PAWANPAHUNE/-Computer-Vision-Based-Laser-Line-Triangulation-Sensor-for-Weld-Bead-Geometry-Measurement/software/assets/checkerboard_9x6_10mm.pdf

Inner corners: 9 x 6 Squares: 10 x 7 Square size: 10 mm
PRINT AT 100% / ACTUAL SIZE. Turn OFF ’Fit to page’. Check: the bar below must measure exactly 100 mm.

100 mm
