PAWANPAHUNE/-Computer-Vision-Based-Laser-Line-Triangulation-Sensor-for-Weld-Bead-Geometry-Measurement/software/assets/checkerboard_9x6_25mm.pdf

Inner corners 9 x 6 | squares 10 x 7 | square 25 mm | PRINT AT 100% (no Fit to page) | CHECK: 4 squares = 100 mm
