PAWANPAHUNE/-Computer-Vision-Based-Laser-Line-Triangulation-Sensor-for-Weld-Bead-Geometry-Measurement/cad/fixture_final/4_pictures/fixture_with_camera_laser_torch_rear.png

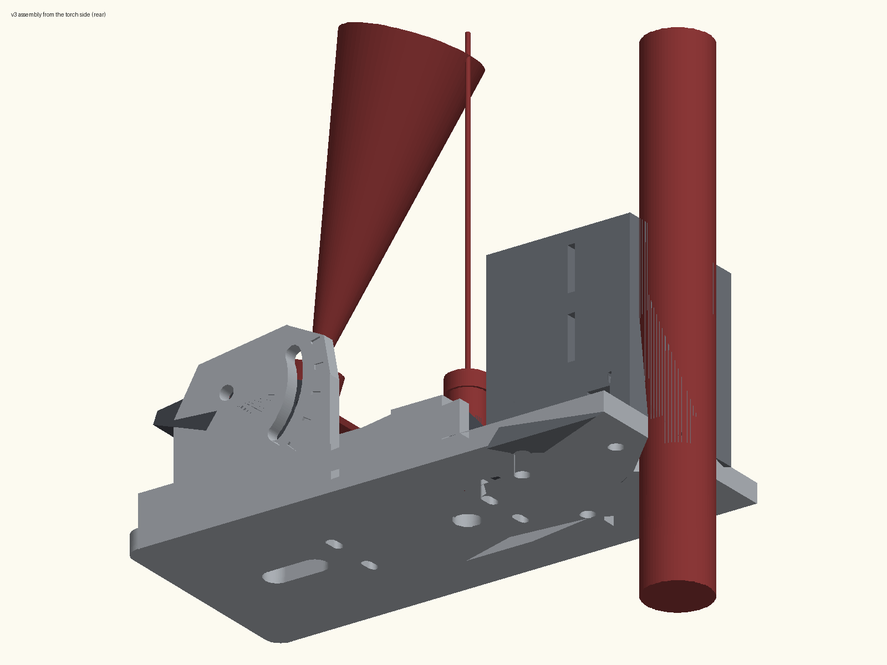
cad/fixture_final/4_pictures/fixture_with_camera_laser_torch_rear.png
