PAWANPAHUNE/-Computer-Vision-Based-Laser-Line-Triangulation-Sensor-for-Weld-Bead-Geometry-Measurement/software/photos/1_checkerboard/view_01.png

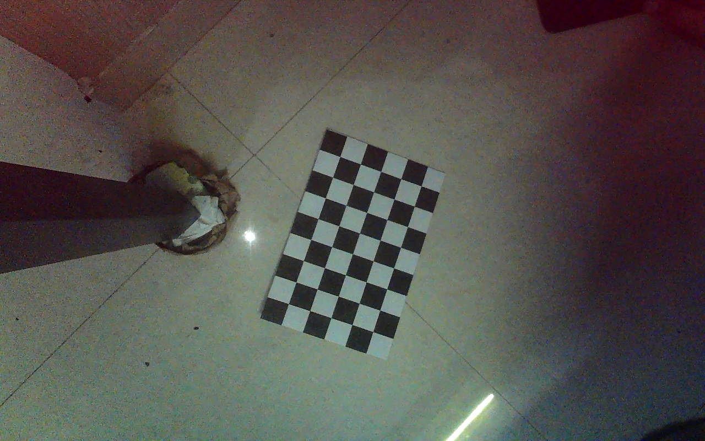
software/photos/1_checkerboard/view_01.png
