PAWANPAHUNE/-Computer-Vision-Based-Laser-Line-Triangulation-Sensor-for-Weld-Bead-Geometry-Measurement/software/photos/2_laser_plane/pose_06_laser_off.png

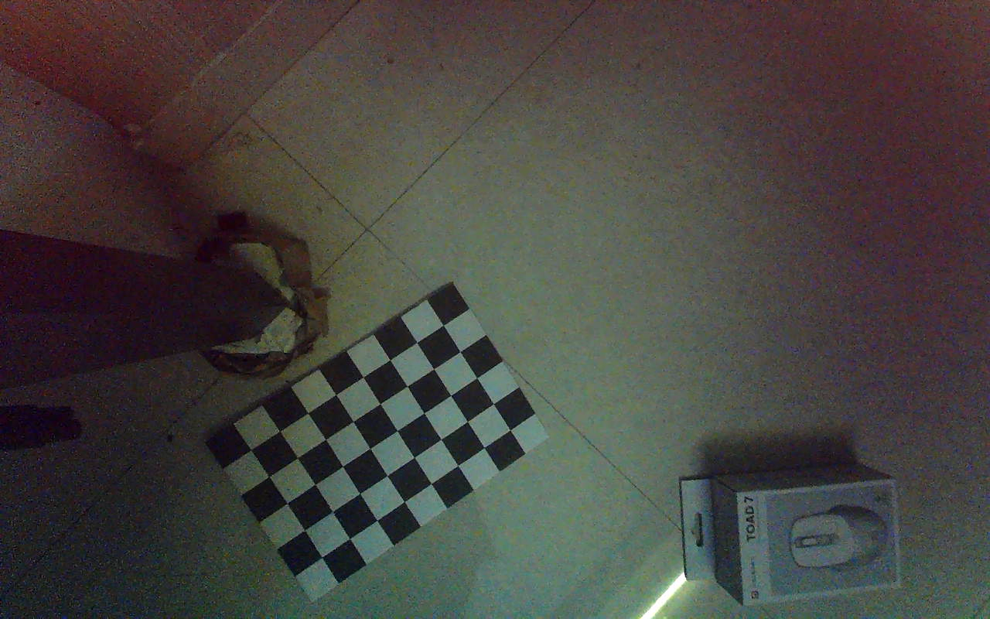
software/photos/2_laser_plane/pose_06_laser_off.png
