PAWANPAHUNE/-Computer-Vision-Based-Laser-Line-Triangulation-Sensor-for-Weld-Bead-Geometry-Measurement/software/photos/4_weld/weld_03.png

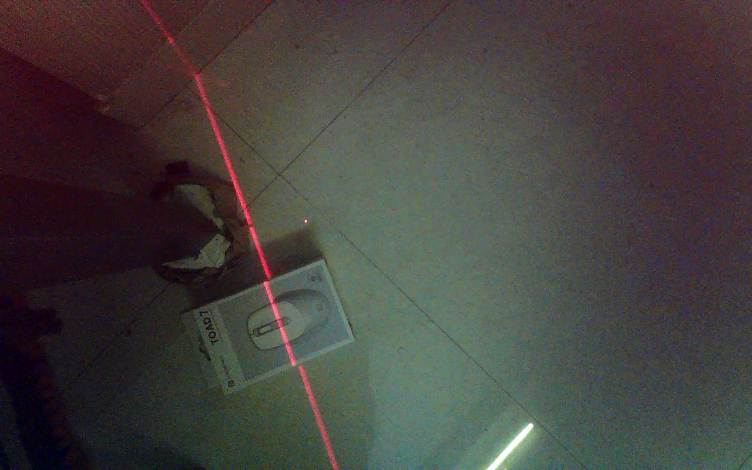
software/photos/4_weld/weld_03.png
