PAWANPAHUNE/-Computer-Vision-Based-Laser-Line-Triangulation-Sensor-for-Weld-Bead-Geometry-Measurement/docs/images/shopping_list.jpg

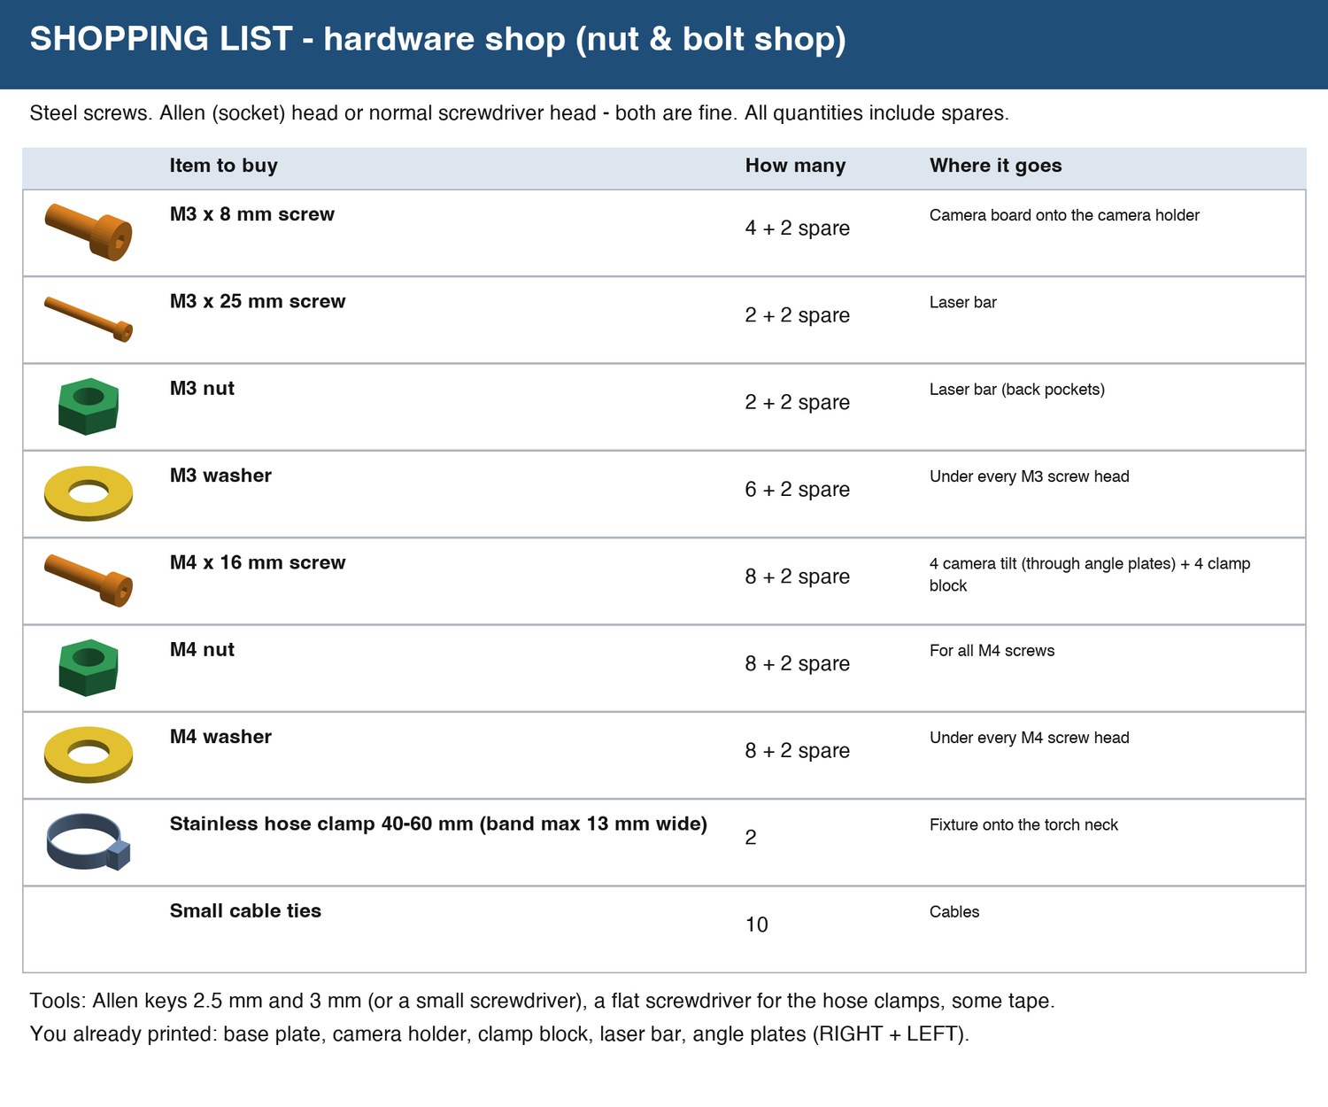
docs/images/shopping_list.jpg
