PAWANPAHUNE/-Computer-Vision-Based-Laser-Line-Triangulation-Sensor-for-Weld-Bead-Geometry-Measurement/cad/design_history/v3/camera_yoke.stl

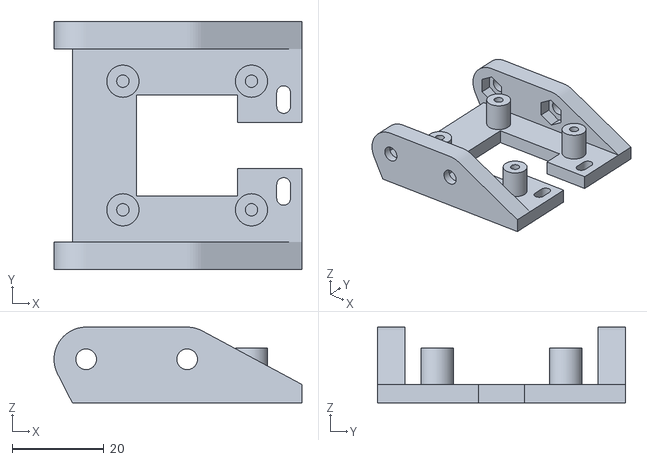
[picture p77: CAD file, 2026-11-10]
cad/design_history/v3/camera_yoke.stl
54.0 x 54.0 x 16.5
