PAWANPAHUNE/-Computer-Vision-Based-Laser-Line-Triangulation-Sensor-for-Weld-Bead-Geometry-Measurement/cad/design_history/v3/printed_hardware/stl/strap_long.stl

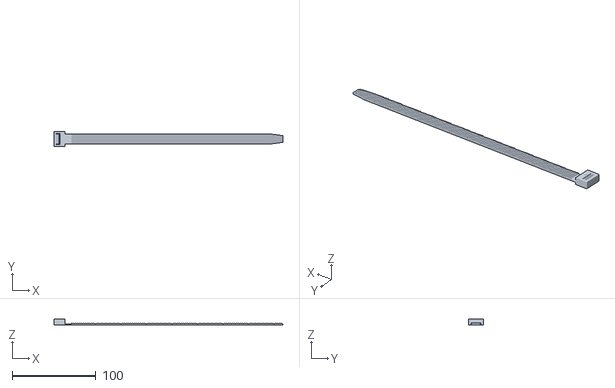
[picture p79: CAD file, 2026-11-10]
cad/design_history/v3/printed_hardware/stl/strap_long.stl
273.0 x 18.0 x 7.00
