PAWANPAHUNE/-Computer-Vision-Based-Laser-Line-Triangulation-Sensor-for-Weld-Bead-Geometry-Measurement/cad/fixture_final/1_fixture_parts_ALREADY_PRINTED/arm_clamp.stl

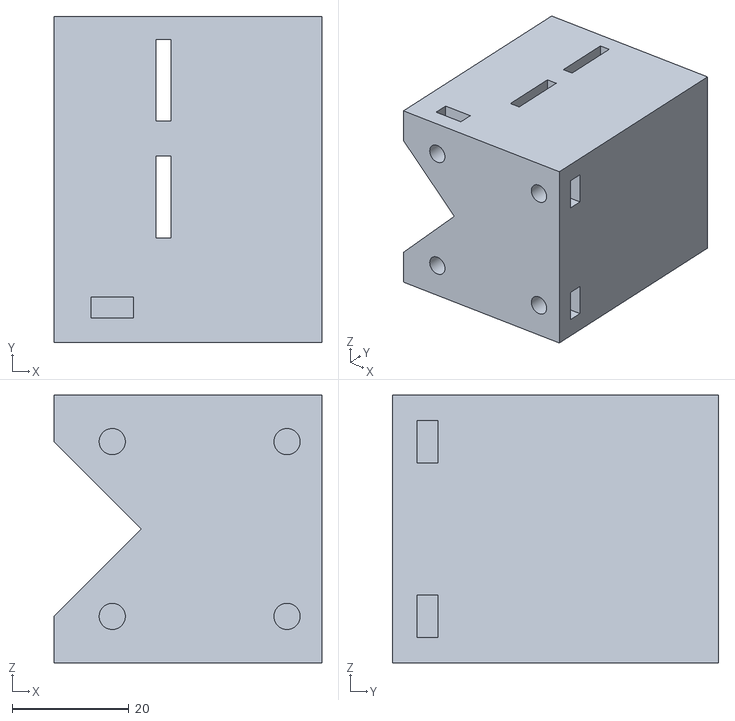
[picture p80: CAD file, 2026-11-10]
cad/fixture_final/1_fixture_parts_ALREADY_PRINTED/arm_clamp.stl
46.0 x 56.0 x 46.0
