PAWANPAHUNE/-Computer-Vision-Based-Laser-Line-Triangulation-Sensor-for-Weld-Bead-Geometry-Measurement/cad/design_history/v3/printed_hardware/stl/angle_plates/angle_plate_25deg_RIGHT.stl

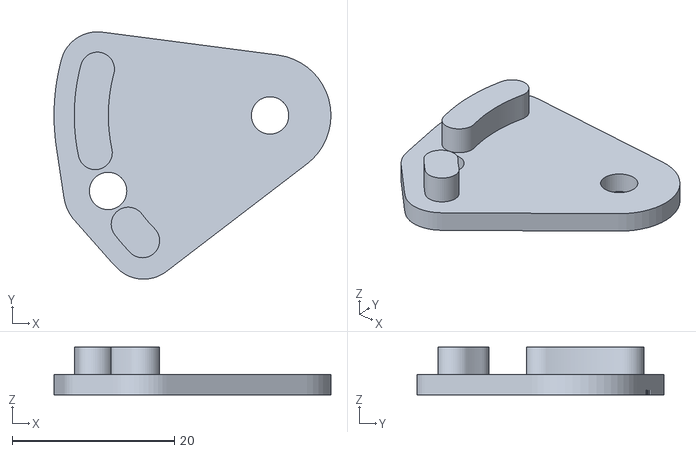
[picture p81: CAD file, 2026-11-10]
cad/design_history/v3/printed_hardware/stl/angle_plates/angle_plate_25deg_RIGHT.stl
34.1 x 30.5 x 5.90
