PAWANPAHUNE/-Computer-Vision-Based-Laser-Line-Triangulation-Sensor-for-Weld-Bead-Geometry-Measurement/cad/fixture_final/1_fixture_parts_ALREADY_PRINTED/base.stl

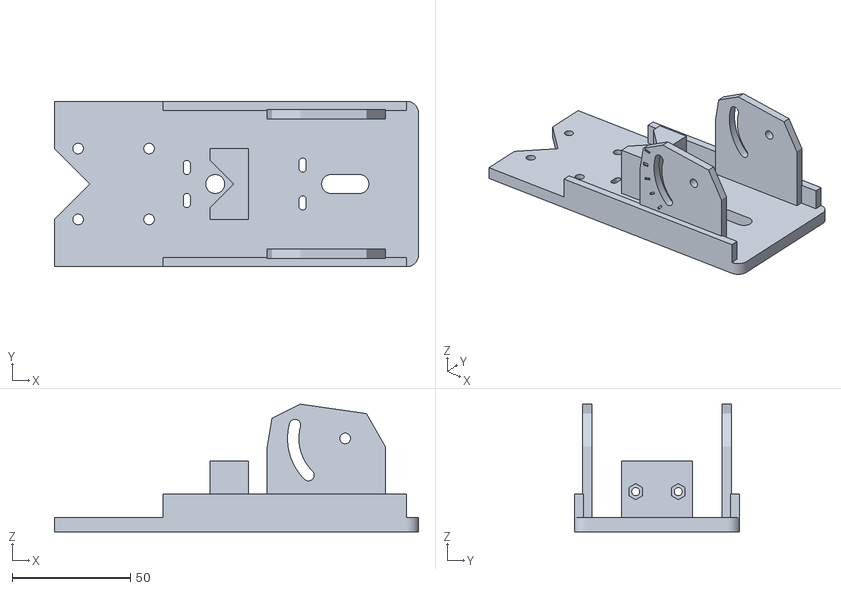
[picture p83: CAD file, 2026-11-10]
cad/fixture_final/1_fixture_parts_ALREADY_PRINTED/base.stl
154.0 x 70.0 x 54.0
