PAWANPAHUNE/-Computer-Vision-Based-Laser-Line-Triangulation-Sensor-for-Weld-Bead-Geometry-Measurement/cad/design_history/v3/laser_bar.stl

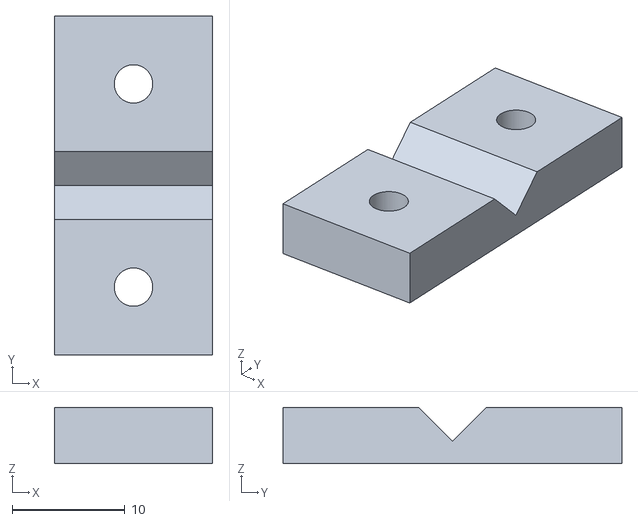
[picture p85: CAD file, 2026-11-10]
cad/design_history/v3/laser_bar.stl
14.0 x 30.0 x 5.00
