PAWANPAHUNE/-Computer-Vision-Based-Laser-Line-Triangulation-Sensor-for-Weld-Bead-Geometry-Measurement/cad/design_history/v3/printed_hardware/stl/laser_clip_size1.stl

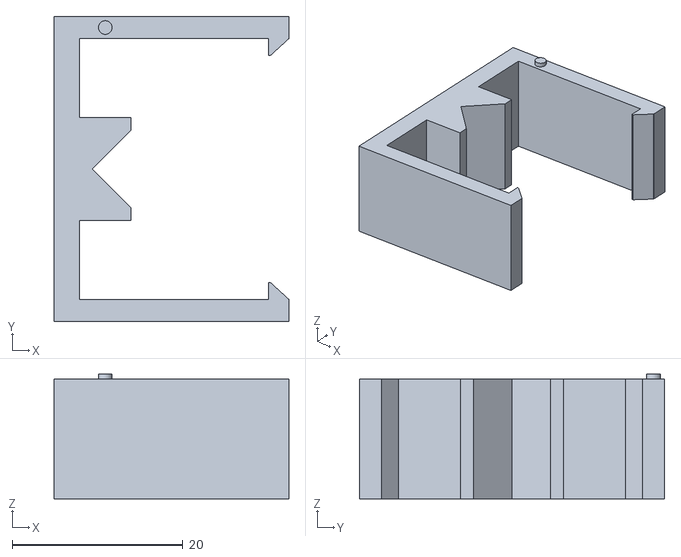
[picture p86: CAD file, 2026-11-10]
cad/design_history/v3/printed_hardware/stl/laser_clip_size1.stl
27.5 x 35.7 x 14.6
