PAWANPAHUNE/-Computer-Vision-Based-Laser-Line-Triangulation-Sensor-for-Weld-Bead-Geometry-Measurement/cad/fixture_final/2_print_pins_clips_straps/yoke_pin.stl

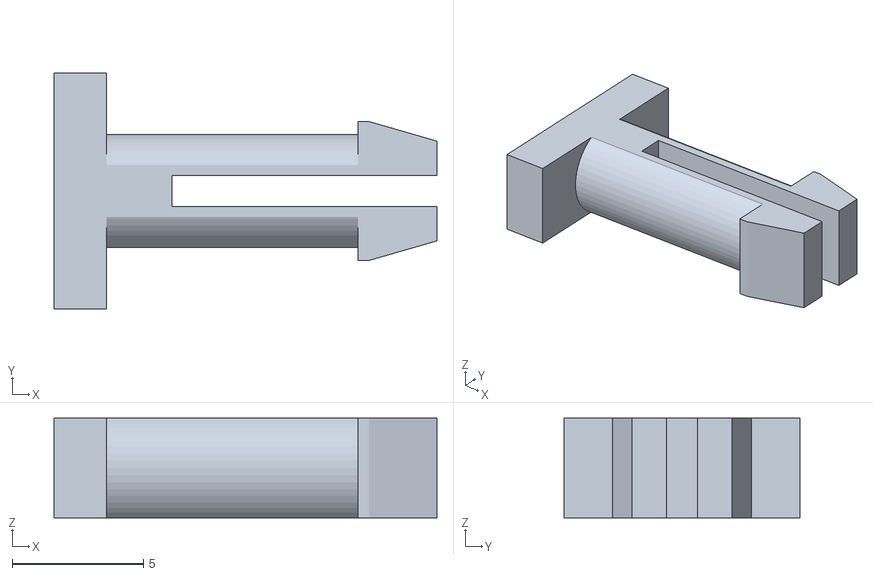
[picture p87: CAD file, 2026-11-10]
cad/fixture_final/2_print_pins_clips_straps/yoke_pin.stl
14.6 x 9.00 x 3.80
