PAWANPAHUNE/-Computer-Vision-Based-Laser-Line-Triangulation-Sensor-for-Weld-Bead-Geometry-Measurement/cad/design_history/v3/printed_hardware/stl/strap_short.stl

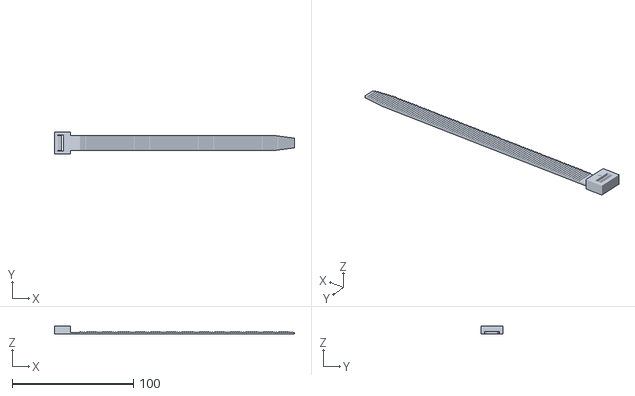
[picture p89: CAD file, 2026-11-10]
cad/design_history/v3/printed_hardware/stl/strap_short.stl
198.0 x 18.0 x 7.00
