PAWANPAHUNE/-Computer-Vision-Based-Laser-Line-Triangulation-Sensor-for-Weld-Bead-Geometry-Measurement/cad/fixture_final/2_print_pins_clips_straps/block_fork_side.stl

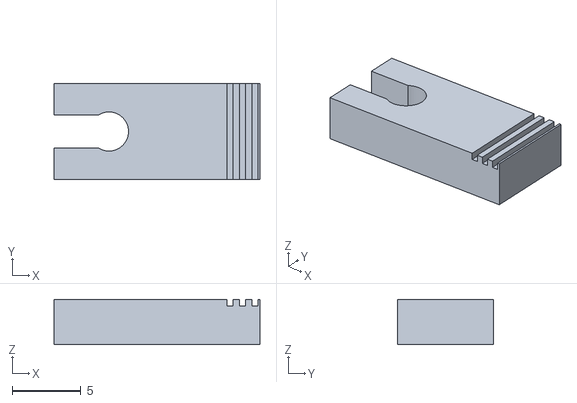
[picture p90: CAD file, 2026-11-10]
cad/fixture_final/2_print_pins_clips_straps/block_fork_side.stl
15.0 x 7.00 x 3.30
