PAWANPAHUNE/-Computer-Vision-Based-Laser-Line-Triangulation-Sensor-for-Weld-Bead-Geometry-Measurement/cad/design_history/v3/printed_hardware/stl/camera_pin.stl

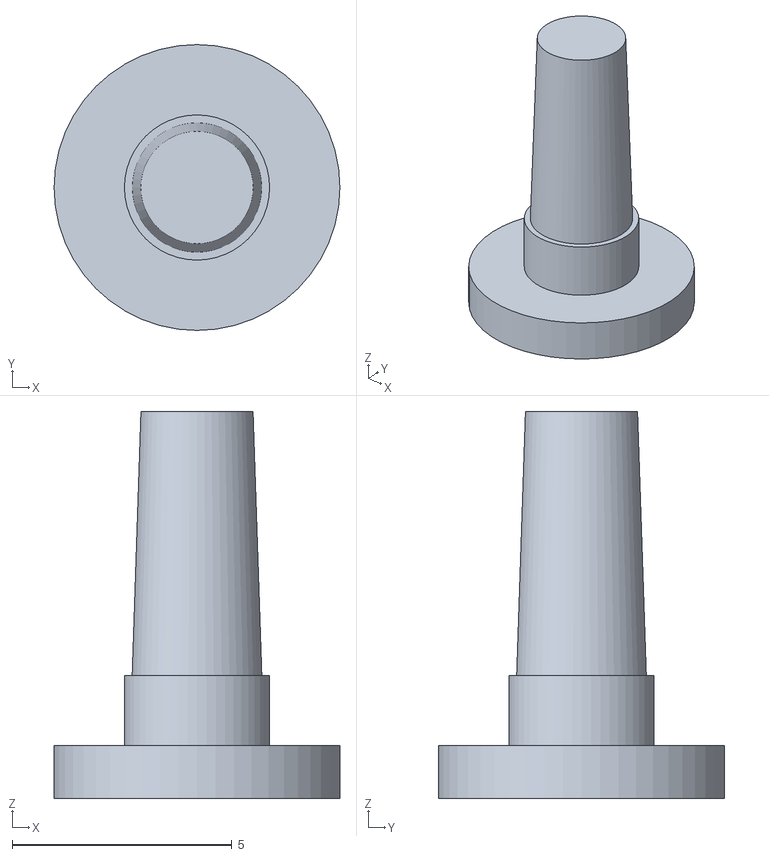
[picture p91: CAD file, 2026-11-10]
cad/design_history/v3/printed_hardware/stl/camera_pin.stl
6.50 x 6.50 x 8.80
