PAWANPAHUNE/-Computer-Vision-Based-Laser-Line-Triangulation-Sensor-for-Weld-Bead-Geometry-Measurement/cad/fixture_final/2_print_pins_clips_straps/block_pin.stl

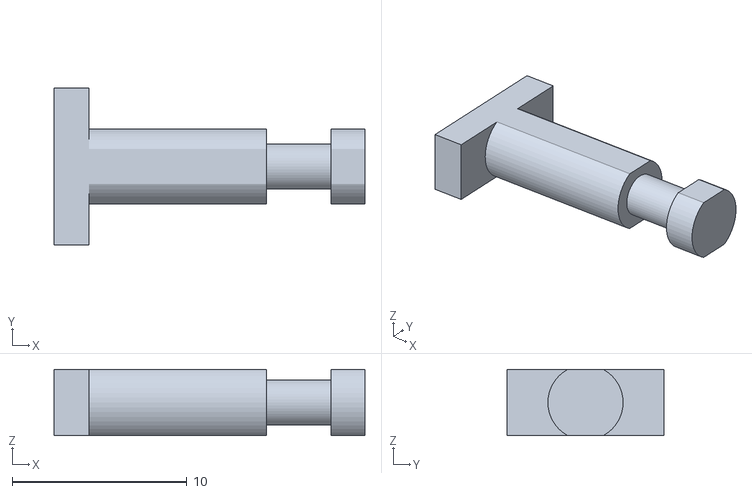
[picture p92: CAD file, 2026-11-10]
cad/fixture_final/2_print_pins_clips_straps/block_pin.stl
17.8 x 9.00 x 3.80
