PAWANPAHUNE/-Computer-Vision-Based-Laser-Line-Triangulation-Sensor-for-Weld-Bead-Geometry-Measurement/cad/fixture_final/3_print_angle_plates/angle_plate_35deg_RIGHT.stl

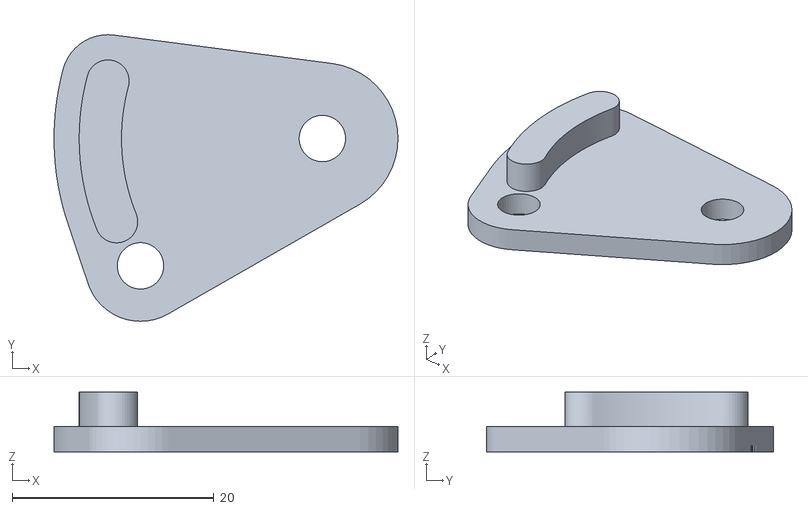
[picture p93: CAD file, 2026-11-10]
cad/fixture_final/3_print_angle_plates/angle_plate_35deg_RIGHT.stl
34.1 x 28.4 x 5.90
