PAWANPAHUNE/-Computer-Vision-Based-Laser-Line-Triangulation-Sensor-for-Weld-Bead-Geometry-Measurement/(list of files, cad)

Other CAD files:
cad/fixture_final/3_print_angle_plates/angle_plate_10deg_RIGHT.stl
cad/fixture_final/3_print_angle_plates/angle_plate_40deg_RIGHT.stl
cad/design_history/v3/printed_hardware/stl/angle_plates/angle_plate_5deg_RIGHT.stl
cad/fixture_final/3_print_angle_plates/angle_plate_30deg_LEFT.stl
cad/design_history/v3/printed_hardware/stl/angle_plates/angle_plate_15deg_RIGHT.stl
cad/fixture_final/3_print_angle_plates/angle_plate_30deg_RIGHT.stl
cad/design_history/v3/printed_hardware/stl/angle_plates/angle_plate_15deg_LEFT.stl
cad/fixture_final/3_print_angle_plates/angle_plate_5deg_RIGHT.stl
cad/design_history/v3/printed_hardware/stl/angle_plates/angle_plate_30deg_RIGHT.stl
cad/fixture_final/3_print_angle_plates/angle_plate_5deg_LEFT.stl
cad/design_history/v3/printed_hardware/stl/angle_plates/angle_plate_5deg_LEFT.stl
cad/design_history/v3/printed_hardware/stl/angle_plates/angle_plate_25deg_LEFT.stl
cad/design_history/v3/printed_hardware/stl/angle_plates/angle_plate_10deg_RIGHT.stl
cad/fixture_final/3_print_angle_plates/angle_plate_15deg_RIGHT.stl
cad/design_history/v3/printed_hardware/stl/angle_plates/angle_plate_40deg_LEFT.stl
cad/design_history/v3/printed_hardware/stl/angle_plates/angle_plate_10deg_LEFT.stl
cad/fixture_final/3_print_angle_plates/angle_plate_10deg_LEFT.stl
cad/design_history/v3/printed_hardware/stl/angle_plates/angle_plate_30deg_LEFT.stl
cad/fixture_final/3_print_angle_plates/angle_plate_20deg_RIGHT.stl
cad/fixture_final/3_print_angle_plates/angle_plate_15deg_LEFT.stl
cad/design_history/v3/printed_hardware/stl/angle_plates/angle_plate_0deg_RIGHT.stl
cad/fixture_final/3_print_angle_plates/angle_plate_0deg_RIGHT.stl
cad/design_history/v3/printed_hardware/stl/angle_plates/angle_plate_20deg_LEFT.stl
cad/fixture_final/3_print_angle_plates/angle_plate_25deg_LEFT.stl
cad/design_history/v3/printed_hardware/stl/angle_plates/angle_plate_20deg_RIGHT.stl
cad/fixture_final/3_print_angle_plates/angle_plate_40deg_LEFT.stl
cad/design_history/v3/printed_hardware/stl/angle_plates/angle_plate_40deg_RIGHT.stl
cad/fixture_final/3_print_angle_plates/angle_plate_20deg_LEFT.stl
cad/design_history/v3/printed_hardware/stl/angle_plates/angle_plate_35deg_LEFT.stl
cad/fixture_final/3_print_angle_plates/angle_plate_35deg_LEFT.stl
cad/design_history/v1/fixture_base_fitcheck.stl
cad/design_history/v1/fixture_laser_yoke_fitcheck.stl
cad/design_history/v1/welding_sensor_fixture.scad
cad/design_history/v2/base.stl
cad/design_history/v2/battery_saddle.stl
cad/design_history/v2/camera_carrier.stl
cad/design_history/v2/camera_yoke.stl
cad/design_history/v2/laser_bracket.stl
cad/design_history/v2/laser_collar_test_gauge.stl
cad/design_history/v2/welding_sensor_fixture_v2.scad
